Loetlicht/rocker-leuchte/docs/konzept.jpg

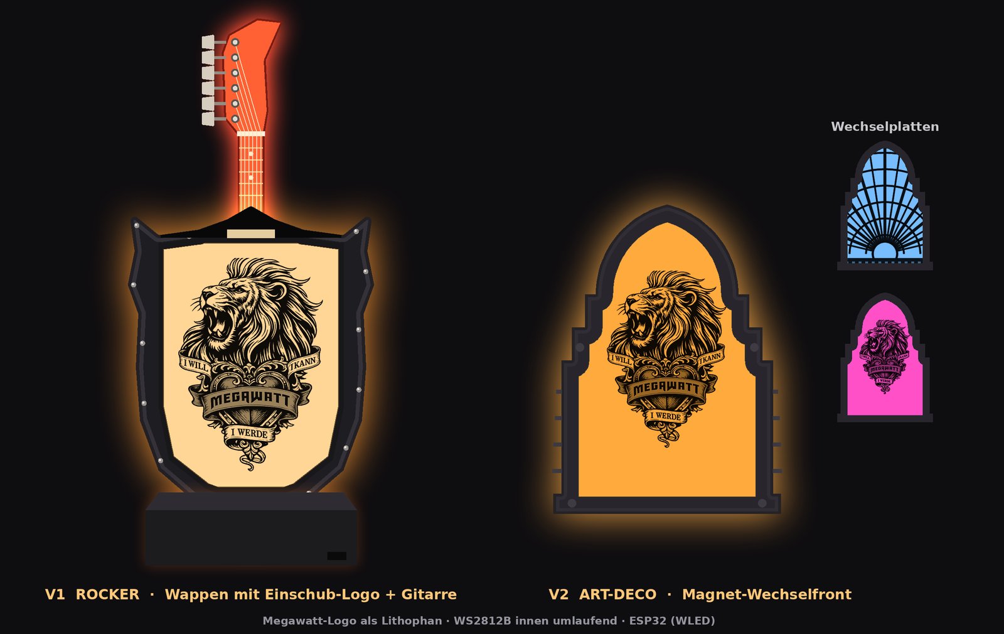
docs/konzept.jpg
