Loetlicht/rocker-leuchte/docs/megawatt.png

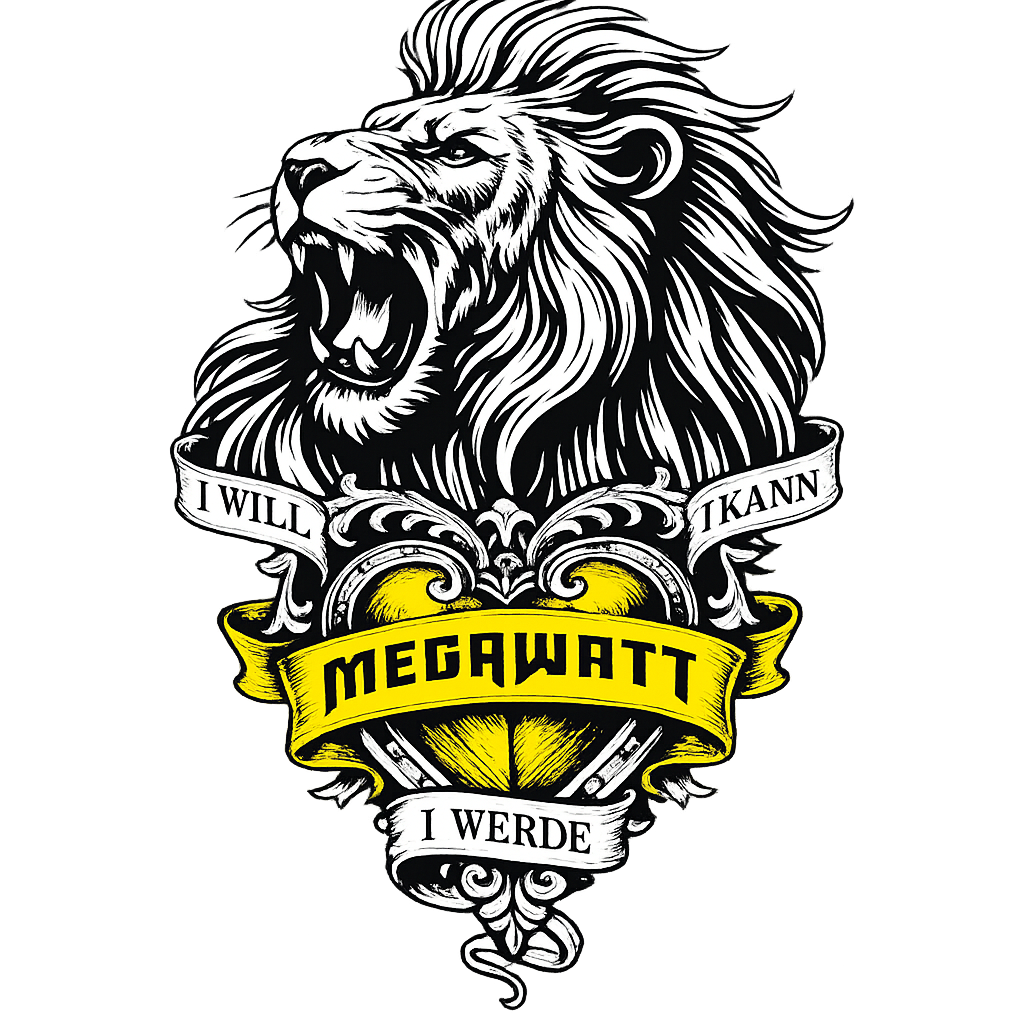
docs/megawatt.png
