Loetlicht/rocker-leuchte/docs/v1_frontplatte_zweiteilig.png

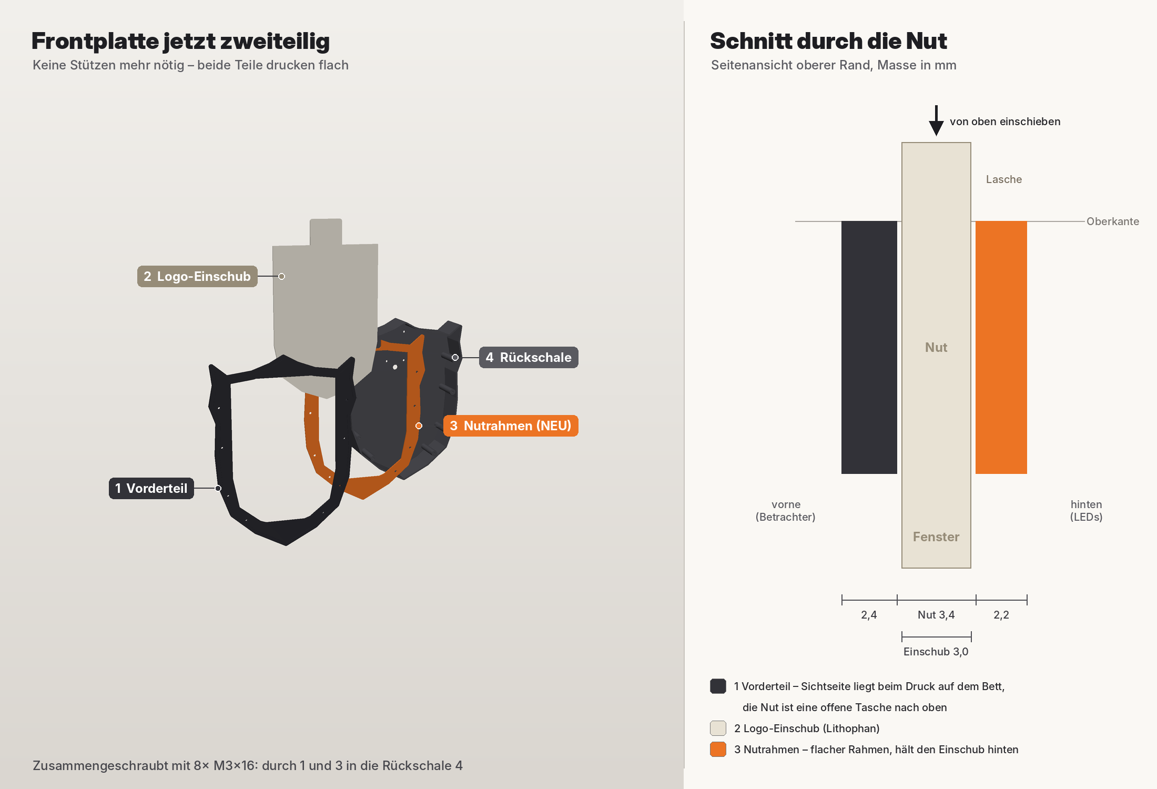
docs/v1_frontplatte_zweiteilig.png
