Loetlicht/rocker-leuchte/stl/v1_frontplatte_nutrahmen.stl

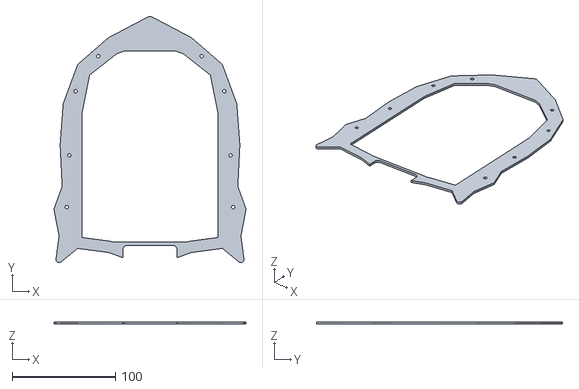
[picture p6: CAD file, 2026-11-03]
stl/v1_frontplatte_nutrahmen.stl
185.8 x 238.5 x 2.20
