Loetlicht/rocker-leuchte/stl/v1_frontplatte_vorne.stl

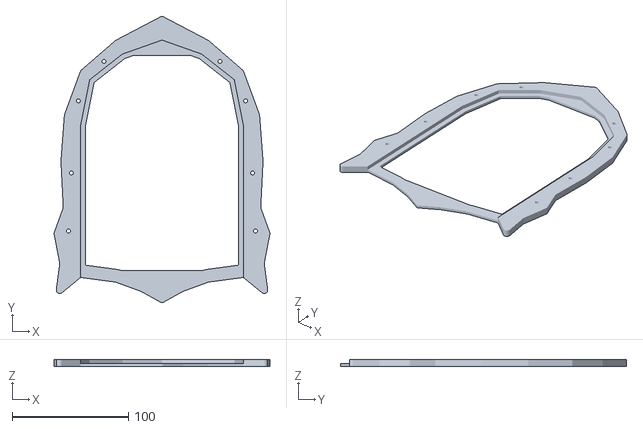
[picture p7: CAD file, 2026-11-03]
stl/v1_frontplatte_vorne.stl
185.8 x 246.2 x 5.80
