Loetlicht/rocker-leuchte/stl/v1_hals_abdeckleiste.stl

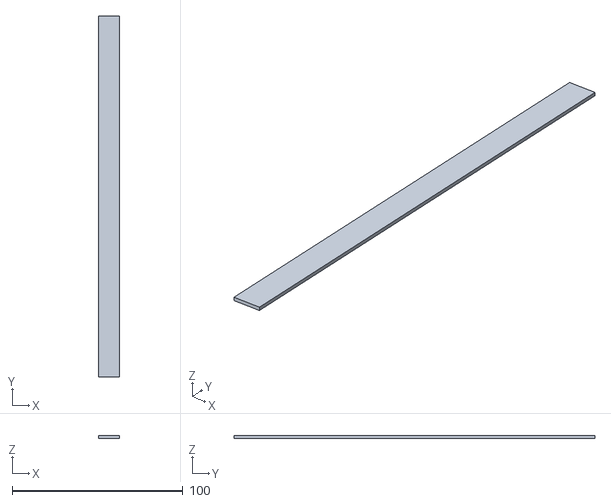
[picture p8: CAD file, 2026-10-16]
stl/v1_hals_abdeckleiste.stl
12.5 x 211.3 x 1.50
