Loetlicht/rocker-leuchte/stl/v1_rueckschale.stl

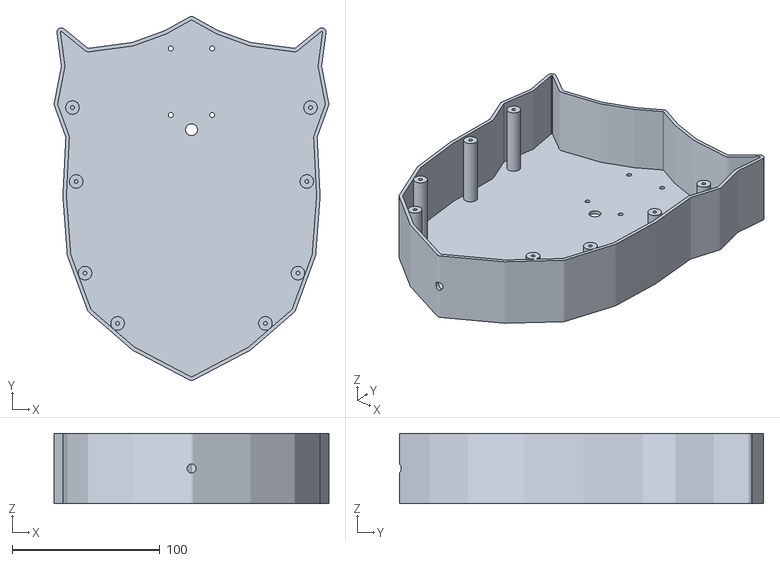
[picture p9: CAD file, 2026-10-16]
stl/v1_rueckschale.stl
185.8 x 246.2 x 47.4
