Loetlicht/rocker-leuchte/stl/v1_sockel_deckel.stl

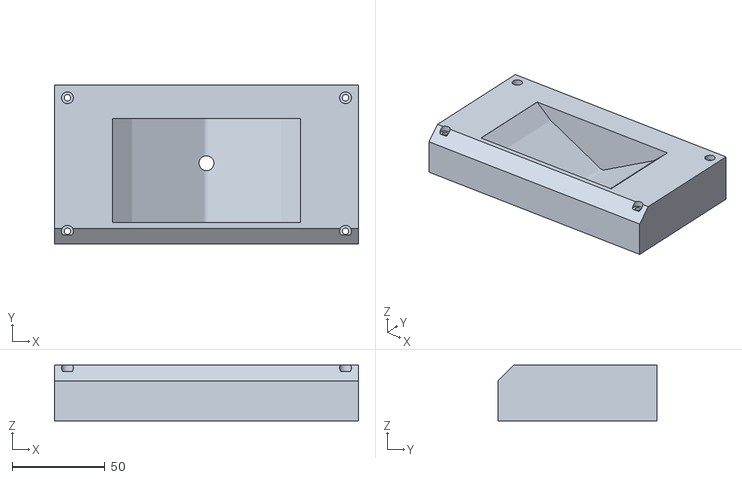
[picture p10: CAD file, 2026-10-16]
stl/v1_sockel_deckel.stl
164.0 x 86.0 x 30.0
