Loetlicht/rocker-leuchte/stl/v1_sockel_unterteil.stl

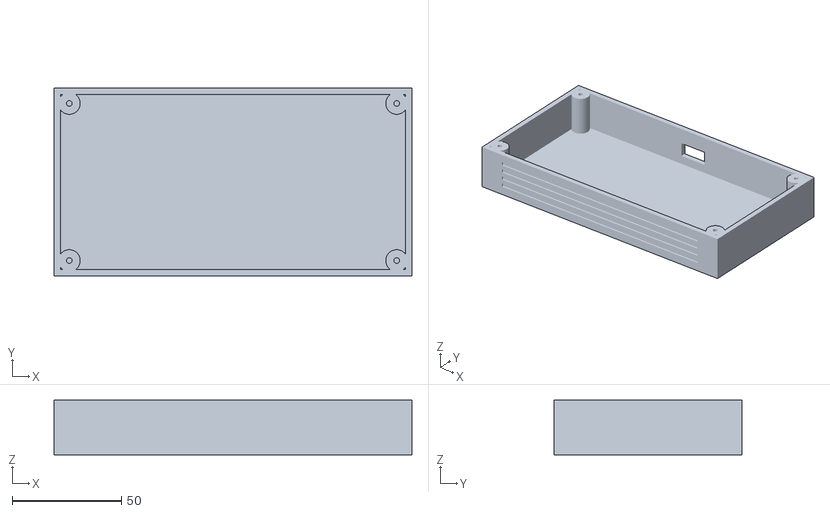
[picture p11: CAD file, 2026-10-16]
stl/v1_sockel_unterteil.stl
164.0 x 86.0 x 25.0
