Loetlicht/rocker-leuchte/stl/v1_logo_megawatt.stl

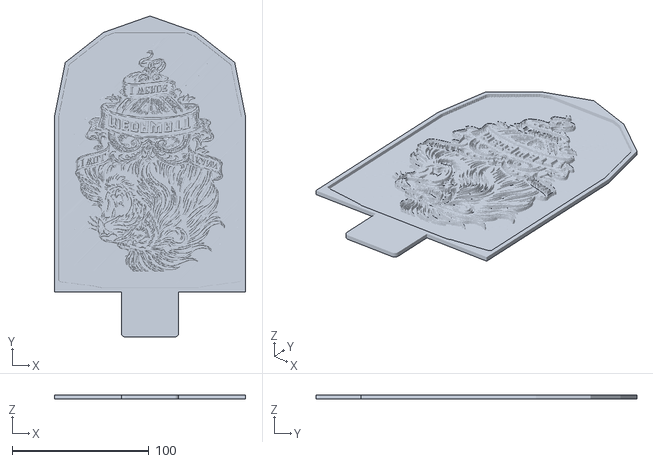
[picture p12: CAD file, 2026-10-16]
stl/v1_logo_megawatt.stl
140.0 x 235.0 x 3.00
