Loetlicht/rocker-leuchte/stl/v1_gitarrenhals.stl

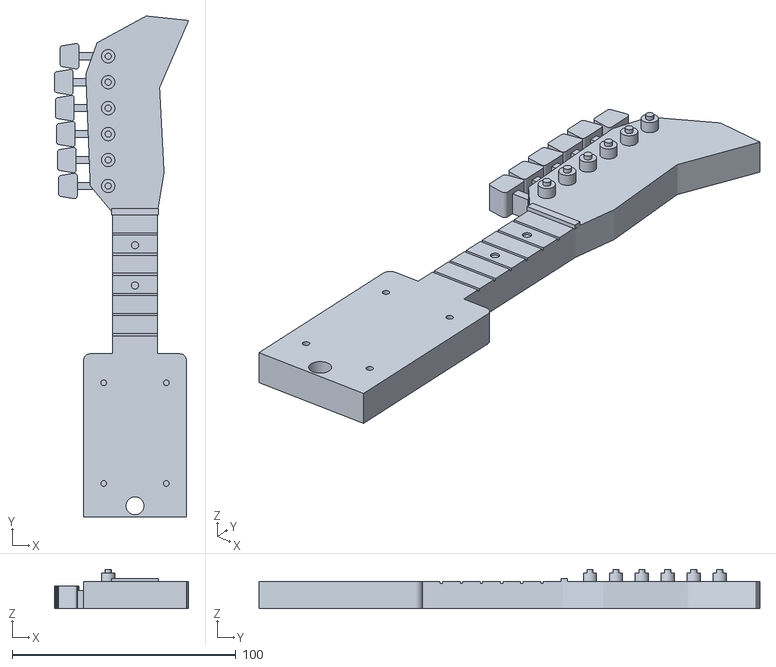
[picture p13: CAD file, 2026-10-16]
stl/v1_gitarrenhals.stl
60.1 x 224.0 x 17.5
