Loetlicht/rocker-leuchte/(commit log)

2026-10-16 STL: Platzhalter und Dateiliste
    Added a README file with details about STL files for 3D printing.
2026-10-16 STL: Rocker-Leuchte V1 (7 Druckteile)
    [v1_frontplatte.stl, v1_gitarrenhals.stl, v1_hals_abdeckleiste.stl, v1_logo_megawatt.stl, v1_rueckschale.stl, v1_sockel_deckel.stl, v1_sockel_unterteil.stl]
2026-10-16 Docs: Vorschaubilder V1 und Megawatt-Logo
2026-10-16 Revise LED settings in README
    Updated LED configuration details including the number of LEDs, segment definitions, and power limits.
2026-10-16 Create README.md for CAD project documentation
    Added README.md with project details and usage instructions.
2026-10-16 Add parametric geometry for Rocker-Leuchte V1
    Implement parametric geometry for Rocker-Leuchte V1 with various shapes and extrusion functions.
2026-10-16 Implement STL export functionality in build_v1.py
2026-10-16 Add lithophane generation script from logo image
    This script generates a lithophane from a logo image, processing the image to handle transparency and outputting a 3D model in STL format.
2026-11-03 Implement frontplatte_vorne and nutrahmen functions
    Added functions for front plate and nut frame with descriptions.
2026-11-03 Frontplatte zweiteilig: Vorderteil + Nutrahmen (ohne Stützen druckbar)
    [v1_frontplatte_nutrahmen.stl, v1_frontplatte_vorne.stl]
