Loetlicht/rocker-leuchte/(notices)

Notices in the files:
README.md:
Lizenz: CC BY-NC-SA 4.0
